Ogbonna-Joseph/HERTZ200/Hertz200/Documents/NOTES.txt

MCU - BULK CONVERTER IN DC JACK TO MCU FOR POWER SIGNAL FUNCTION\

NB-IOT CHIP - TRANSISTOR FOR POWER ON/OFF

ESD ALL

SWITCH FOR BATTERY

CAPACITORS FOR ANTENNAS
