Ogbonna-Joseph/HERTZ200/Hertz200/Documents/HERTZ200_CHIP_CONNECTIONS.png

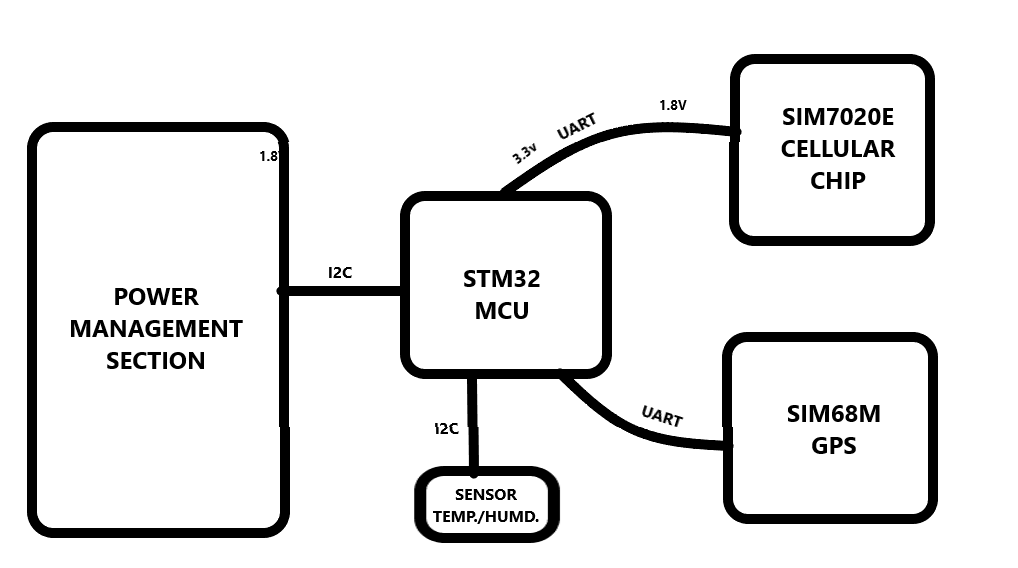
Hertz200/Documents/HERTZ200_CHIP_CONNECTIONS.png
