Ogbonna-Joseph/HERTZ200/Hertz200/Documents/HERTZ200_POWER_BUDGET.png

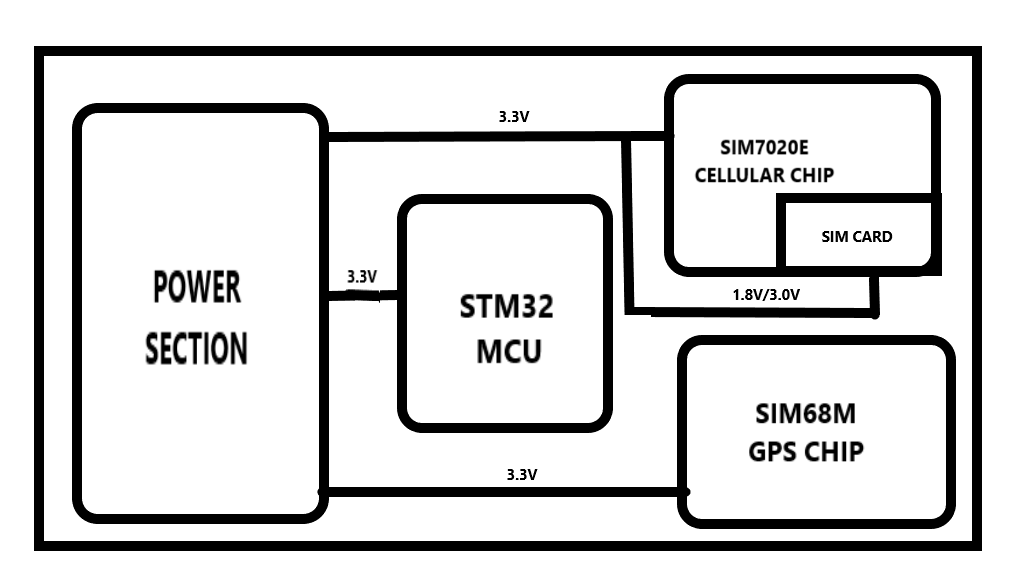
Hertz200/Documents/HERTZ200_POWER_BUDGET.png
