Ogbonna-Joseph/HERTZ200/Hertz200/Documents/Images/Layout001.png

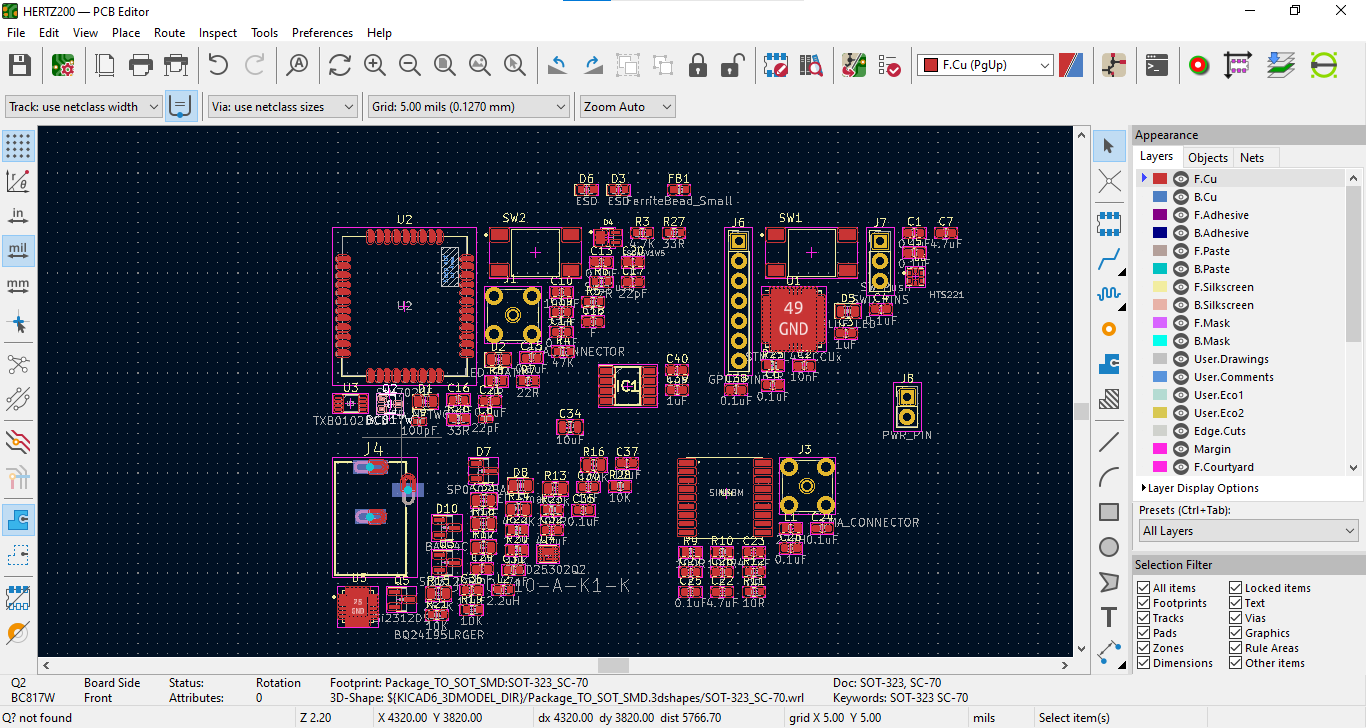
Hertz200/Documents/Images/Layout001.png
