Ogbonna-Joseph/HERTZ200/Hertz200/Documents/Images/layout002.png

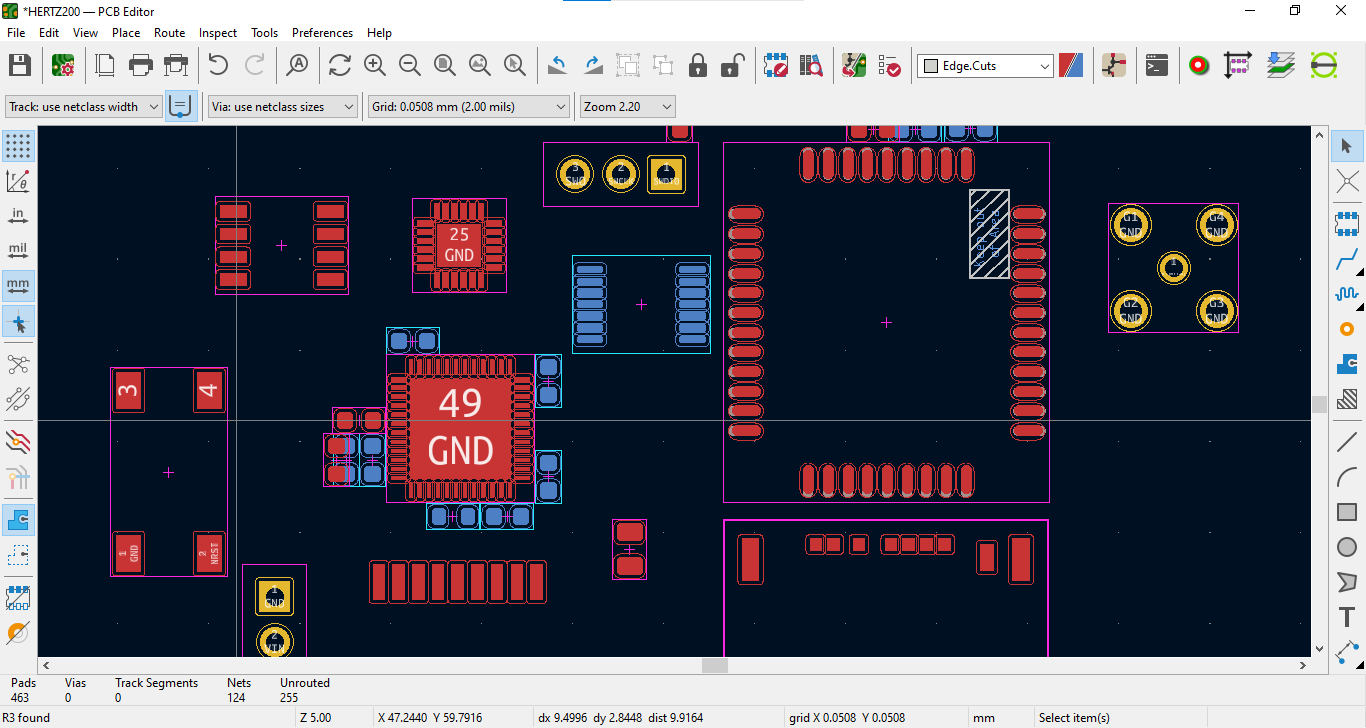
Hertz200/Documents/Images/layout002.png
