Ogbonna-Joseph/HERTZ200/Hertz200/Documents/Images/layout003.png

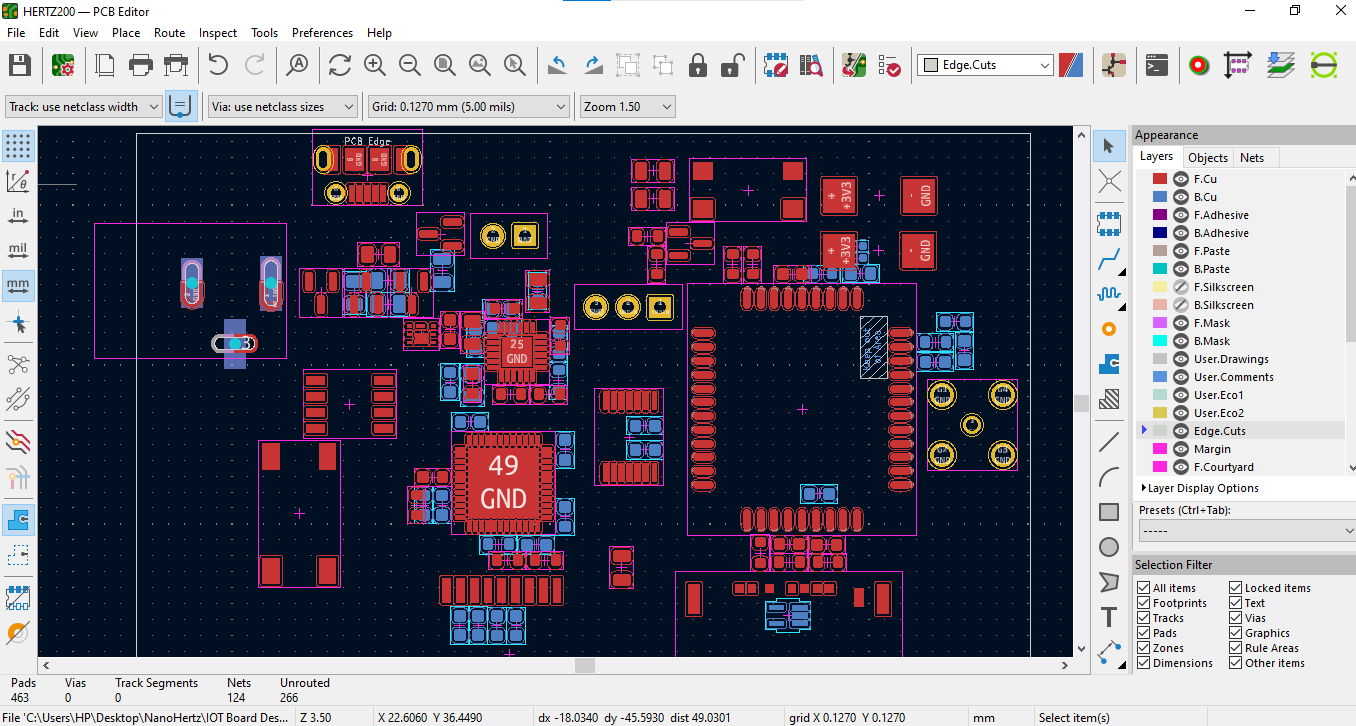
Hertz200/Documents/Images/layout003.png
