Ogbonna-Joseph/HERTZ200/Hertz200/Documents/Images/MCU_PINS.png

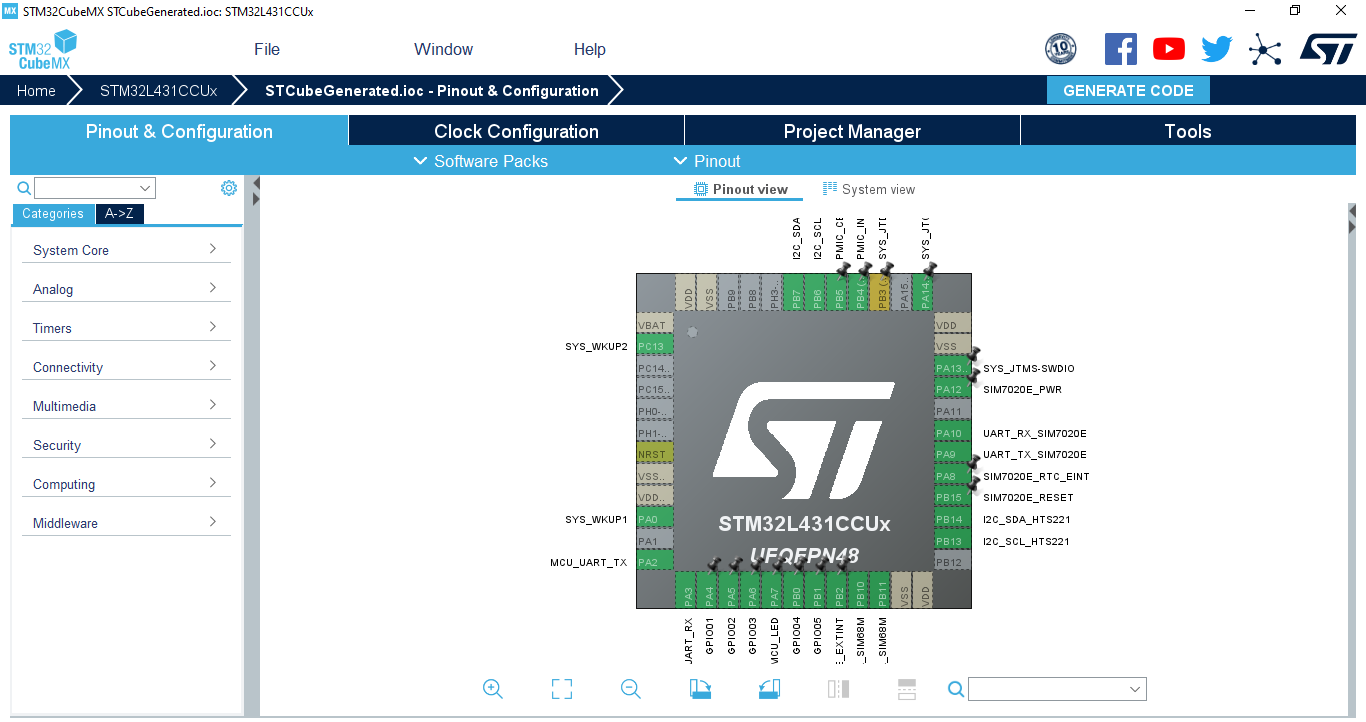
Hertz200/Documents/Images/MCU_PINS.png
