Ogbonna-Joseph/HERTZ200/Hertz200/Documents/Images/SIM7020E SCHEMATICS.png

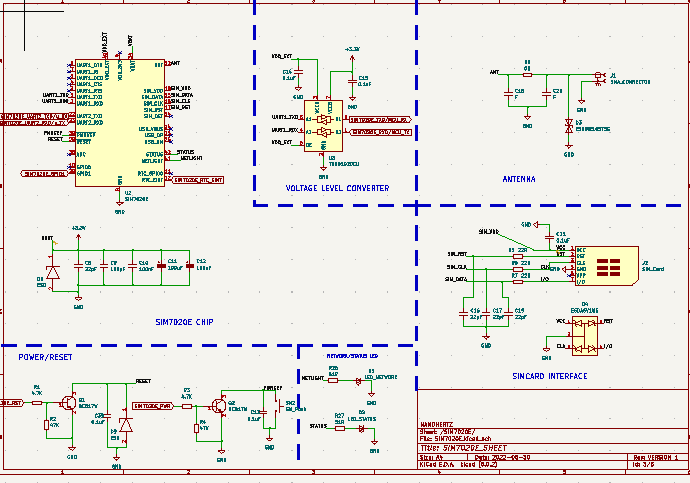
Hertz200/Documents/Images/SIM7020E SCHEMATICS.png
