Ogbonna-Joseph/HERTZ200/Hertz200/Documents/BOM.xlsx

 | QUANTITY | REF. DESIGNATOR | MANUFACTURER | MANF. PART NO. | DESCRIPTION | PACKAGE | TYPE | VALUE | REFERENCE
1 | 1 |  | STMICROELECTRONICS | STM32L431CCU6 | MICROCONTROLLER | UFQFPN-48 | SMT
2 | 1 |  | SIMCOM | SIM7020E | NB-IOT MODULE | LCC, 42PIN | SMT
3 | 1 |  | SIMCOM | SIM68M | GNSS MODULE |  | SMT
4 | 1 |  | TEXAS INSTRUMENT | BQ24195LRGER | BATTERY MANAGEMENT | VQFN-24 | SMT
5 | 1 |  | TEXAS INSTRUMENT | TXB0104PWR | VOLTAGE LEVEL TRANSLATOR | 14-TSSOP | SMT
7 | 2 |  | TEXAS INSTRUMENT | TL3305AF160QG | TACTILE SWITCH |  | SMT
8 | 1 |  | ROHM Semiconductor | BD33HC5MEFJ-ME2 | LDO VOLTAGE REGULATOR | HTSOP-J-8 | SMT
9 | 1 |  | Toshiba | TAR5S33UTE85LF | LDO Voltage Regulators | SOT-353-5 | SMT
10 | 1 |  | Molex | 503960-0696 | SIM CARD CONNECTOR |  | SMT
11 | 2 |  | LPRS | SMA CONNECTOR | COAXIAL CONNECTOR SMA STRAIGHT |  | PTH
12 | 1 |  | Gravitech (https://www.mouser.com/manufacturer/gravitech/) | CON-SOCJ-2155 | DC JACK |  | PTH
13 | 1 |  | TEXAS INSTRUMENT | CSD25302Q2 | POWER MOSFET | WSON-FET-6 | SMT
14 | 2 |  | VISHAY | Si2312DS | TRANSISTOR |  | SMT
15 |  |  |  |  | TRANSISTOR
16 | 1 |  | Epcos/TDK | B82496C3270J | INDUCTOR | 0603 | SMT | 27nH
17 | 1 |  | Murata Electronics | LQM18PN2R2MFHD | INDUCTOR | 0603 | SMT | 2.2uH
18 | 4 |  | Wurth Elektronik | 150080RS75000 | LED | 0805 | SMT
19 | 3 |  | ROHM SEMICONDUCTORS | SDR03EZPF33R0 | RESISTOR | 0603 | SMT | 33R
20 | 1 |  | ROHM SEMICONDUCTORS | SDR03EZPF2201 | RESISTOR | 0603 | SMT | 2.2K
21 | 6 |  | Bourns | CMP0603AFX-1002ELF | RESISTOR | 0603 | SMT | 10K
22 | 2 |  | ROHM SEMICONDUCTORS | SDR10EZPJ103 | RESISTOR | 0805 | SMT | 10K
23 | 1 |  | PANASONIC | ERA-6APB104V | RESISTOR | 0805 | SMT | 100K
24 | 1 |  | PANASONIC | ERA-6AEB2613V | RESISTOR | 0805 | SMT | 262K | 261K ACTUAL VALUE
25 | 1 |  | PANASONIC | ERA-6AEB4992V | RESISTOR | 0805 | SMT | 49.9K
26 | 1 |  | PANASONIC | ERA-6AEB1213V | RESISTOR | 0805 | SMT | 121K
27 | 1 |  | Bourns | CMP0603-FX-10R0ELF | RESISTOR | 0603 | SMT | 10R
28 | 3 |  | Bourns | CMP0603AFX-1000ELF | RESISTOR | 0603 | SMT | 100R
29 | 3 |  | ROHM SEMICONDUCTORS | SFR03EZPF22R0 | RESISTOR | 0603 | SMT | 22R
30 | 1 |  | PANASONIC | ERJ-3EKF4702V | RESISTOR | 0603 | SMT | 47K
31 | 1 |  | ROHM SEMICONDUCTORS | SDR03EZPJ472 | RESISTOR | 0603 | SMT | 4.7K
32 | 1 |  | Bourns | CR0805-JW-131ELF | RESISTOR | 0805 | SMT | 130R
33 | 3 |  | Bourns | CR0603AJ/-000EAS | RESISTOR | 0603 | SMT | 0R
 | 1 |  |  |  | RESISTOR | 0603 | SMT | 33K
35 | 1 |  | Murata Electronics | GRM219R61H105KA73D | CAPACITOR | 0805 | SMT | 1uF
36 | 2 |  | Murata Electronics | GRM21BR61H106KE43K | CAPACITOR | 0805 | SMT | 10uF
37 | 3 |  | Murata Electronics | GRM188R61E106KA73J | CAPACITOR | 0603 | SMT | 10uF
38 | 1 |  | TDK | CGA3E2X7R1H473K080AA | CAPACITOR | 0603 | SMT | 47nF
39 | 1 |  | Murata Electronics | GCM1885C1H102FA16D | CAPACITOR | 0603 | SMT | 1nF
40 | 3 |  | KEMET | C0603C220J5GAC7867 | CAPACITOR | 0603 | SMT | 22pF
41 | 1 |  | KEMET | T491X107K025AT | CAPACITOR POLARIZED |  | SMT | 100uF
42 | 1 |  | KEMET | C0402C101J5GACAUTO | CAPACITOR | 0402 | SMT | 100pF
43 | 1 |  | KEMET | C0402C220J5GACAUTO | CAPACITOR | 0402 | SMT | 22pF
44 | 4 |  | TDK | C1608X6S1A475K080AC | CAPACITOR | 0603 | SMT | 4.7uF
45 | 4 |  | TDK | C1608X5R1H105K080AB | CAPACITOR | 0603 | SMT | 1uF
46 | 2 |  | KEMET | C0603C103K5RAC7013 | CAPACITOR | 0603 | SMT | 10nf
47 | 15 |  | KEMET | C0603C104K5RAC3121 | CAPACITOR | 0603 | SMT | 0.1uF
48 |  |  |  |  | CAPACITOR FOR ANTENNA
49 | 1 |  |  | JST XH 2.54 2-Pin | 2 Pin battery connector |  | PTH |  | https://www.pcboard.ca/jst-xh-2-pin
50 | 1 |  | TE Connectivity (https://www.mouser.com/manufacturer/te-connectivity/) | 87220-3 | CONNECTOR 3 PIN |  | PTH
51 | 1 |  | Molex | 22-28-5070 | CONNECTOR 7 PIN |  | PTH
52 | 1 |  | Murata Electronics | LXES15AAA1-153 | ESD for RF chip (SIM7020E) | 0402 | SMT
 | 2 |  | ONSEMI | ESD9L5.0ST5G | ESD for USB | SOD-923-2 | SMT
 | 1 |  | Molex | 105164-0001 | USB Connector Type B |  | SMT
 | 1 |  | TEXAS INSTRUMENT | TMP451HQDQWTQ1 | TEMPERATURE SENSOR |  | smt
 | 1 |  |  |  | RESISTOR | 0603 | SMT | 200R
 | 1 |  | GCT | USB4125-GF-A-0190 | USB TYPE C |  | SMT
 | 2 |  |  |  | RESISTOR | 0603 | SMT | 5.1K
 | 1 |  | Rectron | BC847-T | TRANSISTOR | SOT23-3 | SMT
