Ogbonna-Joseph/HERTZ200/Hertz200/PCB_DESIGN/HERTZ200/Hertz200_BOM.xlsx

QUANTITY | REF. DESIGNATOR | VALUE | MANF. PART NO. | MANUFACTURER | DESCRIPTION | PACKAGE | TYPE | REFERENCE | PRICE
16 | C1, C4, C5, C6, C10, C11, C13, C14, C15, C20, C21, C24, C26, C27, C28, C48 | 0.1uF | 06033C104JAZ2A | Kyocera AVX | CAPACITOR | 0603 | SMT
2 | C2, C31 | 10nF | C0603C103J5RACTU | KEMET | CAPACITOR | 0603 | SMT
5 | C3, C18, C30, C33, C47 | 1uF | C1608X5R1H105K080AB | TDK | CAPACITOR | 0603 | SMT
2 | C7, C22 | 4.7uF | GRT188R61E475KE13D | MURATA ELECTRONICS | CAPACITOR | 0603 | SMT
1 | C8 | 22pF | C0402C220J5GACAUTO | KEMET | CAPACITOR | 0402 | SMT
1 | C9 | 100pF | C0402C101J5GACAUTO | KEMET | CAPACITOR | 0402 | SMT
5 | C12, C38, C44, C45, C46 | 22uF | CL31A226KOHNNWE | Samsung Electro-Mechanics (https://eu.mouser.com/manufacturer/samsung-electro-mechanics/) | CAPACITOR | 1206 | SMT
3 | C16, C17, C19 | 22pF | C0603C220J5GAC7867 | KEMET | CAPACITOR | 0603 | SMT
1 | C29 | 1uF | GRM219R61H105KA73D | MURATA ELECTRONICS | CAPACITOR | 0805 | SMT
1 | C32 | 10uF | GRM188R61E106KA73J | MURATA ELECTRONICS | CAPACITOR | 0603 | SMT
1 | C34 | 0.1uF | VJ0805Y104JXXPW1BC | Vishay / Vitramon (https://eu.mouser.com/manufacturer/vitramon/) | CAPACITOR | 0805 | SMT
3 | R1, R8, R12 | 0R | CR0603AJ/-000EAS | BOURNS | RESISTOR | 0603 | SMT
1 | R2 | 130R | CR0805-JW-131ELF | BOURNS | RESISTOR | 0805 | SMT
1 | R3 | 4.7K | SDR03EZPJ472 | ROHM SEMI CONDUCTORS | RESISTOR | 0603 | SMT
1 | R4 | 47K | ERJ-3EKF4702V | PANASONIC | RESISTOR | 0603 | SMT
3 | R5, R6, R7 | 22R | SFR03EZPF22R0 | ROHM SEMI CONDUCTORS | RESISTOR | 0603 | SMT
2 | R9, R10 | 100R | CMP0603AFX-1000ELF | BOURNS | RESISTOR | 0603 | SMT
1 | R11 | 10R | CMP0603-FX-10R0ELF | BOURNS | RESISTOR | 0603 | SMT
1 | R13 | 2.2K | SDR03EZPF2201 | ROHM SEMI CONDUCTORS | RESISTOR | 0603 | SMT
2 | R14, R15 | 5.1M | ESR10EZPJ515 | ROHM SEMI CONDUCTORS | RESISTOR | 0805 | SMT
1 | R16 | 330R | CMP0805AFX-3300ELF | BOURNS | RESISTOR | 0805 | SMT
1 | R24 | 33K | SDR03EZPJ333 | ROHM SEMI CONDUCTORS | RESISTOR | 0603 | SMT
3 | R25, R26, R27 | 33R | SDR03EZPF33R0 | ROHM SEMI CONDUCTORS | RESISTOR | 0603 | SMT
7 | R29, R30, R37, R39, R42, R50, R51 | 10K | CMP0603AFX-1002ELF | BOURNS | RESISTOR | 0603 | SMT
2 | R33, R34 | 5.1K | SDR03EZPF5101 | ROHM SEMI CONDUCTORS | RESISTOR | 0603 | SMT
1 | R35 | 23.7K | ERJ-UP3F2372V | PANASONIC | RESISTOR | 0603 | SMT
1 | R36 | 15K | SDR03EZPJ153 | ROHM SEMI CONDUCTORS | RESISTOR | 0603 | SMT
1 | R38 | 47.5K | ERJ-UP3F4752V | PANASONIC | RESISTOR | 0603 | SMT
1 | R40 | 13.3K | ERJ-UP3F1332V | PANASONIC | RESISTOR | 0603 | SMT
3 | R43, R44, R45 | 2K | SFR03EZPF2001 | ROHM SEMI CONDUCTORS | RESISTOR | 0603 | SMT
1 | R46 | 20m | RL3264-6-R020-FN | CYNTEC | RESISTOR | 2512 | SMT
1 | R47 | 1K | RC0603FR-071KL | YAGEO | RESISTOR | 0603 | SMT
1 | R48 | 37.4K | RC0603FR-0737K4L | YAGEO | RESISTOR | 0603 | SMT
1 | R49 | 31.6K | RC0603FR-0731K6L | YAGEO | RESISTOR | 0603 | SMT
1 | D1 | LED_NETWORK | 150080RS75000 | Wurth Elektronik | LED | 0805 | SMT
1 | D2 | LED_STATUS | 150080RS75000 | Wurth Elektronik | LED | 0805 | SMT
1 | D3 | LXES15AAA1-153 | LXES15AAA1-153 | MURATA ELECTRONICS |  | 0402 | SMT
1 | D4 | ESDA6V1W5 | ESDA6V1W5 | STMicroelectronics | ESD |  | SMT
1 | D5 | BLUE_LED | 150060RS75000 | Wurth Elektronik | LED | 0805 | SMT
1 | D6 | ESD |  |  |  | 0603 | SMT
2 | D7, D9 | ESD9L5.0ST5G | ESD9L5.0ST5G | ONSEMI | ESD
1 | D10 | BLUE_LED | LB Q39E-L2OO-35-1 | ams OSRAM | LED | 0603 | SMT
2 | D11, D12 | BLUE_LED | LB Q39E-L2OO-35-1 | ams OSRAM | LED | 0603 | SMT
1 | IC1 | BD33HC5MEFJ-ME2 | BD33HC5MEFJ-ME2 | ROHM Semiconductor | LDO REGULATOR | HTSOP-J-8 | SMT
1 | IC2 | TMP451HQDQWTQ1 | TMP451HQDQWTQ1 | TEXAS INSTRUMENT | TEMPERATURE SENSOR | WSON-8 | SMT
1 | IC3 | BQ29701DSET | BQ29701DSET | TEXAS INSTRUMENT | BATTERY MANAGEMENT | WSON-6 | SMT
2 | J1, J3 | SMA_CONNECTOR | SMA CONNECTOR | LPRS | CONNECTOR STRAIGHT |  | PTH
1 | J2 | 503960-0696 | 503960-0696 | MOLEX | SIM CARD CONNECTOR |  | SMT
1 | J4 | GPIO_PINS |  |  |  |  | PTH
1 | J5 | 105164-0001 | 105164-0001 | MOLEX | USB TYPE B CONNECTOR |  | SMT
1 | J7 | SWD_PINS | 87220-3 | TE CONNECTIVITY | FEMALE PIN CONNECTOR |  | PTH
1 | J8 | USB4125-GF-A-0190_REVA2 | USB4125-GF-A-0190 | GCT | USB TYPE C CONNECTOR |  | SMT
1 | L1 | 27nH | B82496C3270J | Epcos/TDK | INDUCTOR | 0603 | SMT
1 | L3 | 1.5uH | 744311150 | Wurth Elektronik | INDUCTOR |  | SMT
1 | PS1 | TAR5SB33_TE85L,F_ | TAR5S33UTE85LF | TOSHIBA | LDO REGULATOR | SOT-353-5 | SMT
2 | Q1, Q3 | CSD16301Q2 | CSD16301Q2 | TEXAS INSTRUMENT | MOSFET | WSON-6 | SMT
1 | Q2 | BC847-T | BC847-T | RECTRON | TRASISTOR | SOT23-3 | SMT
2 | S1, S2 | TL3305AF160QG | TL3305AF160QG | TEXAS INSTRUMENT | TACTILE SWITCH |  | SMT
1 | U1 | STM32L431CCUx | STM32L431CCU6 | STMicroelectronics | MICROCONTROLLER | UFQFPN-48 | SMT
1 | U2 | SIM7020E | SIM7020E | SIMCOM | NB-IOT MODULE | LCC, 42PIN | SMT
1 | U3 | TXB0104PW | TXB0104PWR | TEXAS INSTRUMENT | VOLTAGE LEVEL TRANSLATOR | 14-TSSOP | SMT
1 | U4 | SIM68M | SIM68M | SIMCOM | GPS/GNSS |  | SMT
1 | U6 | MP2636GR-P | MP2636GR-P | Monolithic Power Systems (MPS) | BATTERY MANAGEMENT |  | SMT
2 | U7, U8 | 100uF | T491X107K025AT | KEMET | CAPACITOR POLARIZED |  | SMT
1 | BT1 |  | JST XH 2.54mm 2-Pin |  | FEMALE BATTERY CONNECTOR |  | PTH
