Ogbonna-Joseph/HERTZ200/Hertz200/Documents/Hert200_Parameters01.xlsx

Sheet: Sheet1
MCU/CHIPSET | TYPE | OPERATING VOLTAGE (V) | INTERFACE | CURRENT (mA) | POWER (W) | SLEEP MODE(uA)
STM32L431CC | PROCESSOR | 3.3 | USART | 140 | 0.462 | 0.300
 |  |  | SPI
 |  |  | I2C
SIM7020E | NB-IOT CELLULAR | 3.3 | UART | 800 | 2.640 | 3.400
SIM68M | GNSS/GPS | 3.3 | UART | 30 | 0.100 | 14.000
HT221 TEMP/HUMIDITY | SENSOR |  | SPI
 |  |  | I2C
BQ24195RGER | BATTERY IC | 6-24 | I2C | 3A MAX
MCU TOTAL CRT/PWR |  |  |  | 970 | 3.202 | 18.000
TXB0102DCUT | Volatge Level Shifter
BATTERY | LITHIUM ION | 3.8 X 2 |  | (5-10)AH
CAPACITORS | SMD | 0.1uF/50V | 603 | C0603C104K5RAC3121
 |  | 1uF/50V | 0603 | CGA3E3X5R1H105K080AB

Sheet: Sheet2
CAPACITORS
PART NO. | VALUE | VOLTAGE | DESCRIPTION | size | PRICE $
C0603C104K5RAC3121 | 0.1uF | 50V | for power and other function | 0603 | 0.13
C0603C103K5RAC7013 | 10nF | 50V | STM32 L4 VDDA | 0603 | 0.13
C1608X5R1H105K080AB | 1uF | 50V | STM32 L4 VDDA | 0603 | 0.22
C0402C220J5GACAUTO | 22pF | 50V | SIM7020E VDD | 0402 | 0.11
C0402C101J5GACAUTO | 100pF | 50v | SIM7020E VDD | 0402 | 0.12
T491X107K025AT | 100uF | 25v | SIM7020E VDD |  | 3.34
C0603C220J5GAC7867 | 22pF | 50V | SIM7020E SIM SLOT | 0603 | 0.15
C1608X6S1A475K080AC | 4.7uF | 50V | SIM68 POWER | 0603 | 0.25
GCM1885C1H102FA16D | 1nF | 50V | PMIC | 0603 | 0.37
CGA3E2X7R1H473K080AA | 47nF | 50V | PMIC | 0603 | 0.16
GRM188R61E106KA73J | 10uF | 25v |  | 0603 | 0.30
LED
150080RS75000 |  | 2V | led | 805 | 0.19
RESISTOR
R13-R18 |  | 1W |  | 0805
Resistors |  | 300mW | ROHM SEMICONDUCTORS | 0603 | 0.17
BAT54C |  |  |  | SOT 23 | 0.43
CDBU0130-HF |  |  | Schokley diode |  | 0.5
DCJ250-10-A-K1-K |  |  | DC Barrel Jack |  | 0.74
BD33HC5MEFJ-ME2 |  | 3.3 | LDO 3.3V |  | 1.43
TL3305AF160QG |  |  | SWITCH TACTILE |  | 0.21
LQG18HN27NJ00D |  |  | GPS INDUCTOR | 603 | 0.20
LQM18PN2R2MFHD |  |  | PMIC INDUCTOR | 603 | 0.31
105017-0001 |  |  | Female USB connector |  | 0.95
503960-0696 |  |  | SIM CONNECTOR from Molex |  | 2.82
TXB0104QPWRQ1 |  |  | 4bit BiDir Logic level converter |  | 1.41
