Ogbonna-Joseph/HERTZ200/Hertz200/PCB_DESIGN/HERTZ200/HERTZ200.kicad_pcb

## KiCad design Hertz200/PCB_DESIGN/HERTZ200/HERTZ200.kicad_pcb (2022-10-03)

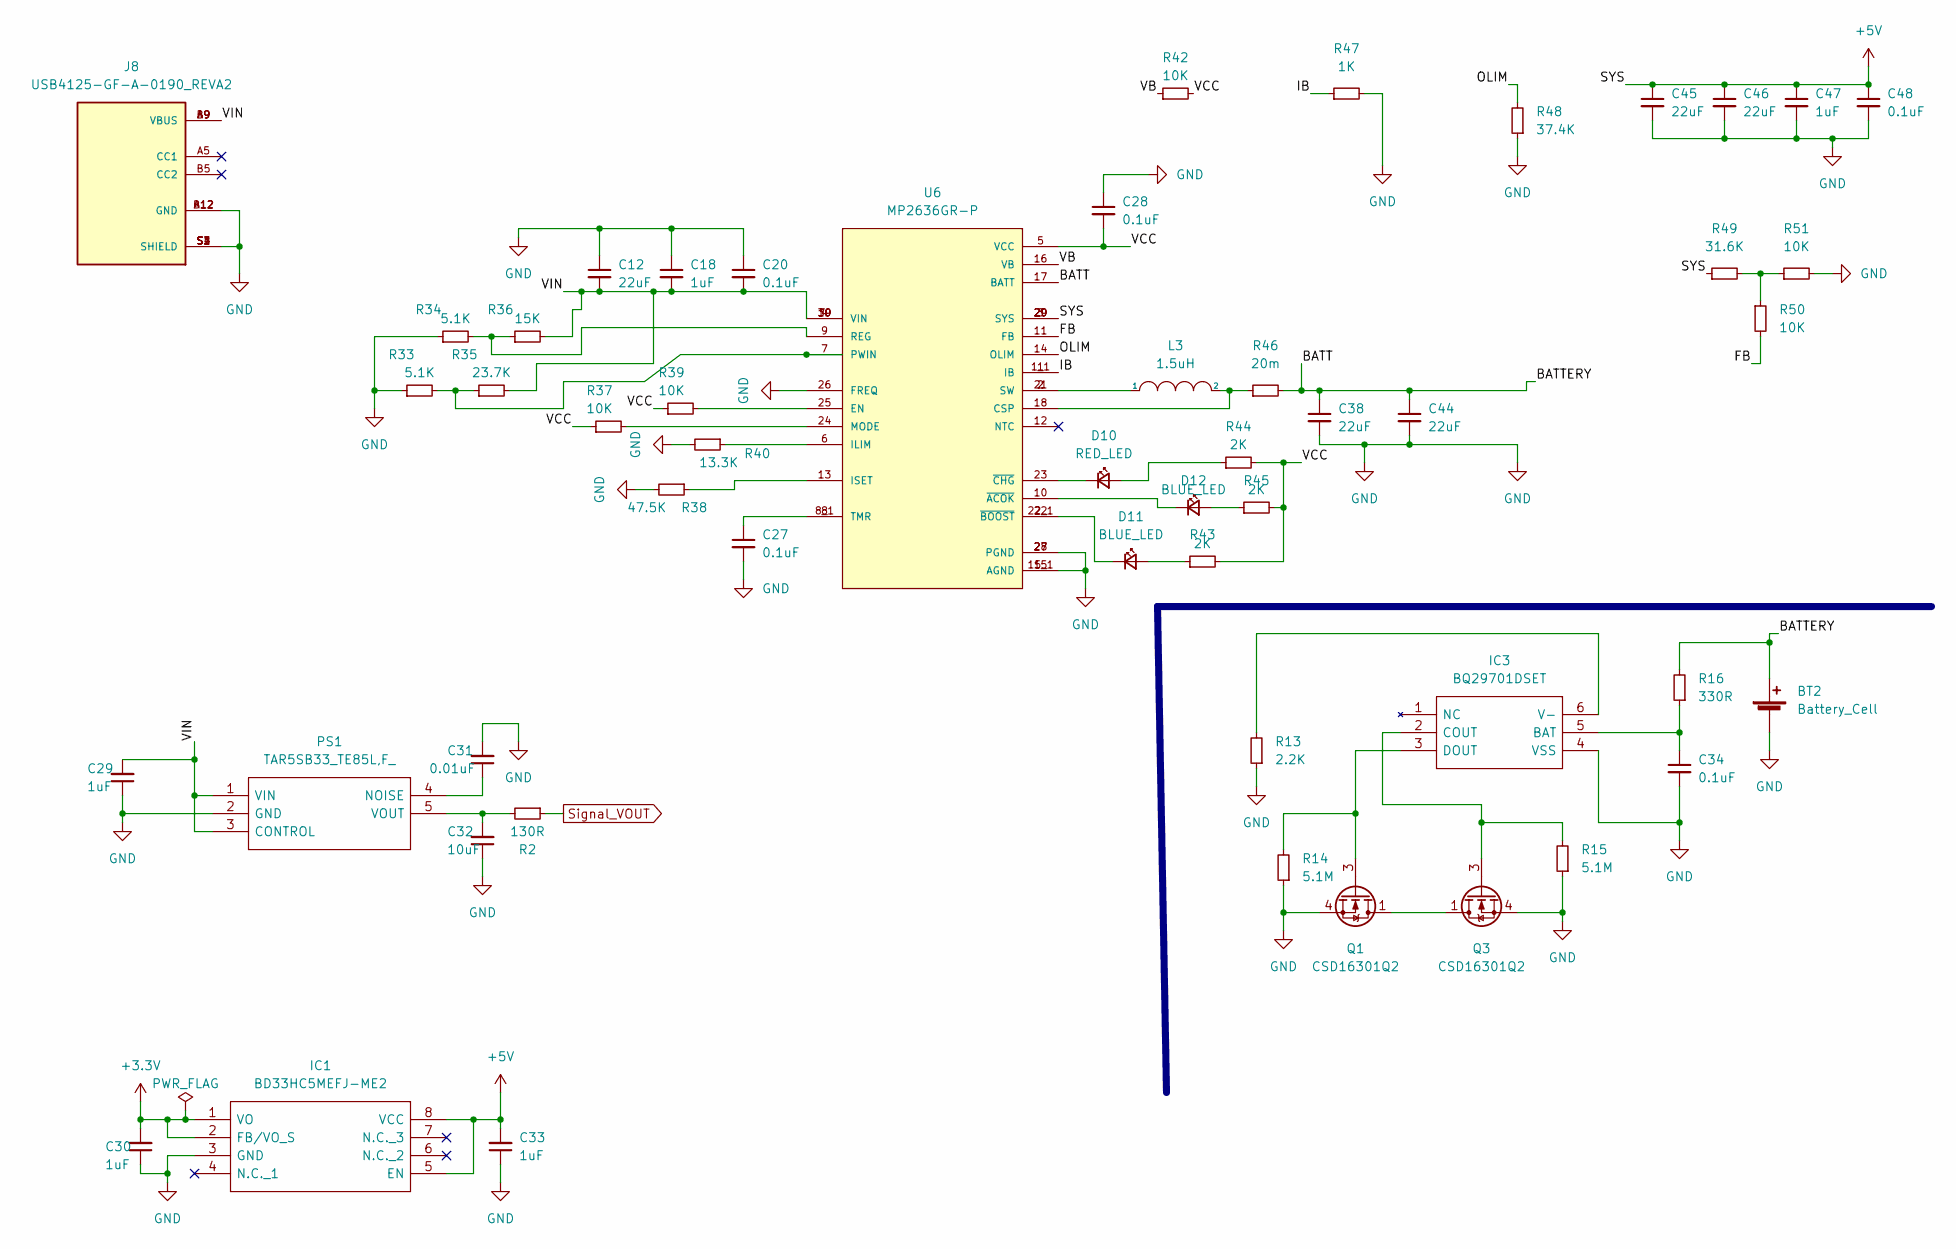
[picture p8: schematic MP2636.kicad_sch]

Parts:
BT2: Battery_Cell; PinHeader_1x02_P2.54mm_Vertical
C12, C38, C44, C45, C46: 22uF; C_1206_3216Metric
C18, C30, C33, C47: 1uF; C_0603_1608Metric
C20, C27, C28, C48: 0.1uF; C_0603_1608Metric
C29: 1uF; C_0805_2012Metric
C31: 0.01uF; C_0603_1608Metric
C32: 10uF; C_0603_1608Metric
C34: 0.1uF; R_0805_2012Metric
D10: RED_LED; LED_0603_1608Metric
D11, D12: BLUE_LED; LED_0603_1608Metric
IC1: BD33HC5MEFJ-ME2; SOIC127P600X100-8N; Mouser Part Number 755-BD33HC5MEFJ-ME2
IC3: BQ29701DSET; Mouser Part Number 595-BQ29701DSET
J8: USB4125-GF-A-0190_REVA2; GCT_USB4125-GF-A-0190_REVA2; PARTREV Rev A2
L3: 1.5uH; WE-HCI_7030_7040_705023
PS1: TAR5SB33_TE85L,F_; SOT95P275X140-5N; Manufacturer_Part_Number TAR5SB33(TE85L,F); Mouser Part Number 757-TAR5SB33TE85LF
Q1, Q3: CSD16301Q2; Texas_DQK
R2: 130R; R_0805_2012Metric
R13: 2.2K; R_0603_1608Metric
R14, R15: 5.1M; R_0805_2012Metric
R16: 330R; R_0805_2012Metric
R33, R34: 5.1K; R_0603_1608Metric
R35: 23.7K; R_0603_1608Metric
R36: 15K; R_0603_1608Metric
R37, R39, R42, R50, R51: 10K; R_0603_1608Metric
R38: 47.5K; R_0603_1608Metric
R40: 13.3K; R_0603_1608Metric
R43, R44, R45: 2K; R_0603_1608Metric
R46: 20m; R_2512_6332Metric
R47: 1K; R_0603_1608Metric
R48: 37.4K; R_0603_1608Metric
R49: 31.6K; R_0603_1608Metric
U6: MP2636GR-P; IC_MP2636GR-P; PARTREV 1.02

Connections:
+3V3: C30.2, IC1.1 (VO), IC1.2 (FB/VO_S); also elsewhere on the board
+5V: C33.2, C45.1, C46.1, C47.1, C48.1, IC1.5 (EN), IC1.8 (VCC), R49.1, U6.3 (SYS), U6.20 (SYS), U6.29 (SYS)
/MP2636/BATT: BT2.1 (+), C38.1, C44.1, R16.2, R46.2, U6.17 (BATT)
/MP2636/FB: R50.2, U6.11 (FB)
/MP2636/IB: R47.1, U6.1 (IB), U6.1_1 (IB)
/MP2636/OLIM: R48.2, U6.14 (OLIM)
/MP2636/VB: R42.1, U6.16 (VB)
/MP2636/VCC: C28.2, R37.1, R39.1, R42.2, R43.2, R44.2, R45.2, U6.5 (VCC)
/MP2636/VIN: C12.2, C18.2, C20.2, C29.2, J8.A9 (VBUS), J8.B9 (VBUS), PS1.1 (VIN), PS1.3 (CONTROL), R35.2, R36.2, U6.4 (VIN), U6.19 (VIN), U6.30 (VIN)
GND: BT2.2 (-), C12.1, C18.1, C20.1, C27.2, C28.1, C29.1, C30.1, C31.2, C32.1, C33.1, C34.2, C38.2, C44.2, C45.2, C46.2, C47.2, C48.2, IC1.3 (GND), IC3.4 (VSS), J8.A12 (GND), J8.B12 (GND), J8.S1 (SHIELD), J8.S2 (SHIELD), J8.S3 (SHIELD), J8.S4 (SHIELD), PS1.2 (GND), Q1.4 (S), Q1.7 (S), Q3.4 (S), Q3.7 (S), R13.1, R14.1, R15.1, R33.1, R34.1, R38.2, R40.2, R47.2, R48.1, R51.2, U6.15 (AGND), U6.15_1 (AGND), U6.26 (FREQ), U6.27 (PGND), U6.28 (PGND); also elsewhere on the board
unnamed: C27.1, U6.8 (TMR), U6.8_1 (TMR)
unnamed: C31.1, PS1.4 (NOISE)
unnamed: C32.2, PS1.5 (VOUT), R2.2
unnamed: C34.1, IC3.5 (BAT), R16.1
unnamed: D10.1 (K), U6.23 (~CHG)
unnamed: D10.2 (A), R44.1
unnamed: D11.1 (K), U6.22 (~BOOST), U6.22_1 (~BOOST)
unnamed: D11.2 (A), R43.1
unnamed 53: D12.1 (K), U6.10 (~ACOK); also elsewhere on the board
unnamed 54: D12.2 (A), R45.1; also elsewhere on the board
unnamed: IC3.2 (COUT), Q3.3 (G), R15.2
unnamed: IC3.3 (DOUT), Q1.3 (G), R14.2
unnamed: IC3.6 (V-), R13.2
unnamed: L3.1, U6.2 (SW), U6.21 (SW)
unnamed: L3.2, R46.1, U6.18 (CSP)
unnamed: Q1.1 (D), Q1.2 (D), Q1.5 (D), Q1.6 (D), Q1.8 (D), Q3.1 (D), Q3.2 (D), Q3.5 (D), Q3.6 (D), Q3.8 (D)
unnamed: R33.2, R35.1, U6.7 (PWIN)
unnamed: R34.2, R36.1, U6.9 (REG)
unnamed: R37.2, U6.24 (MODE)
unnamed: R38.1, U6.13 (ISET)
unnamed: R39.2, U6.25 (EN)
unnamed: R40.1, U6.6 (ILIM)
unnamed: R49.2, R50.1, R51.1
Signal_VOUT: R2.1; also elsewhere on the board

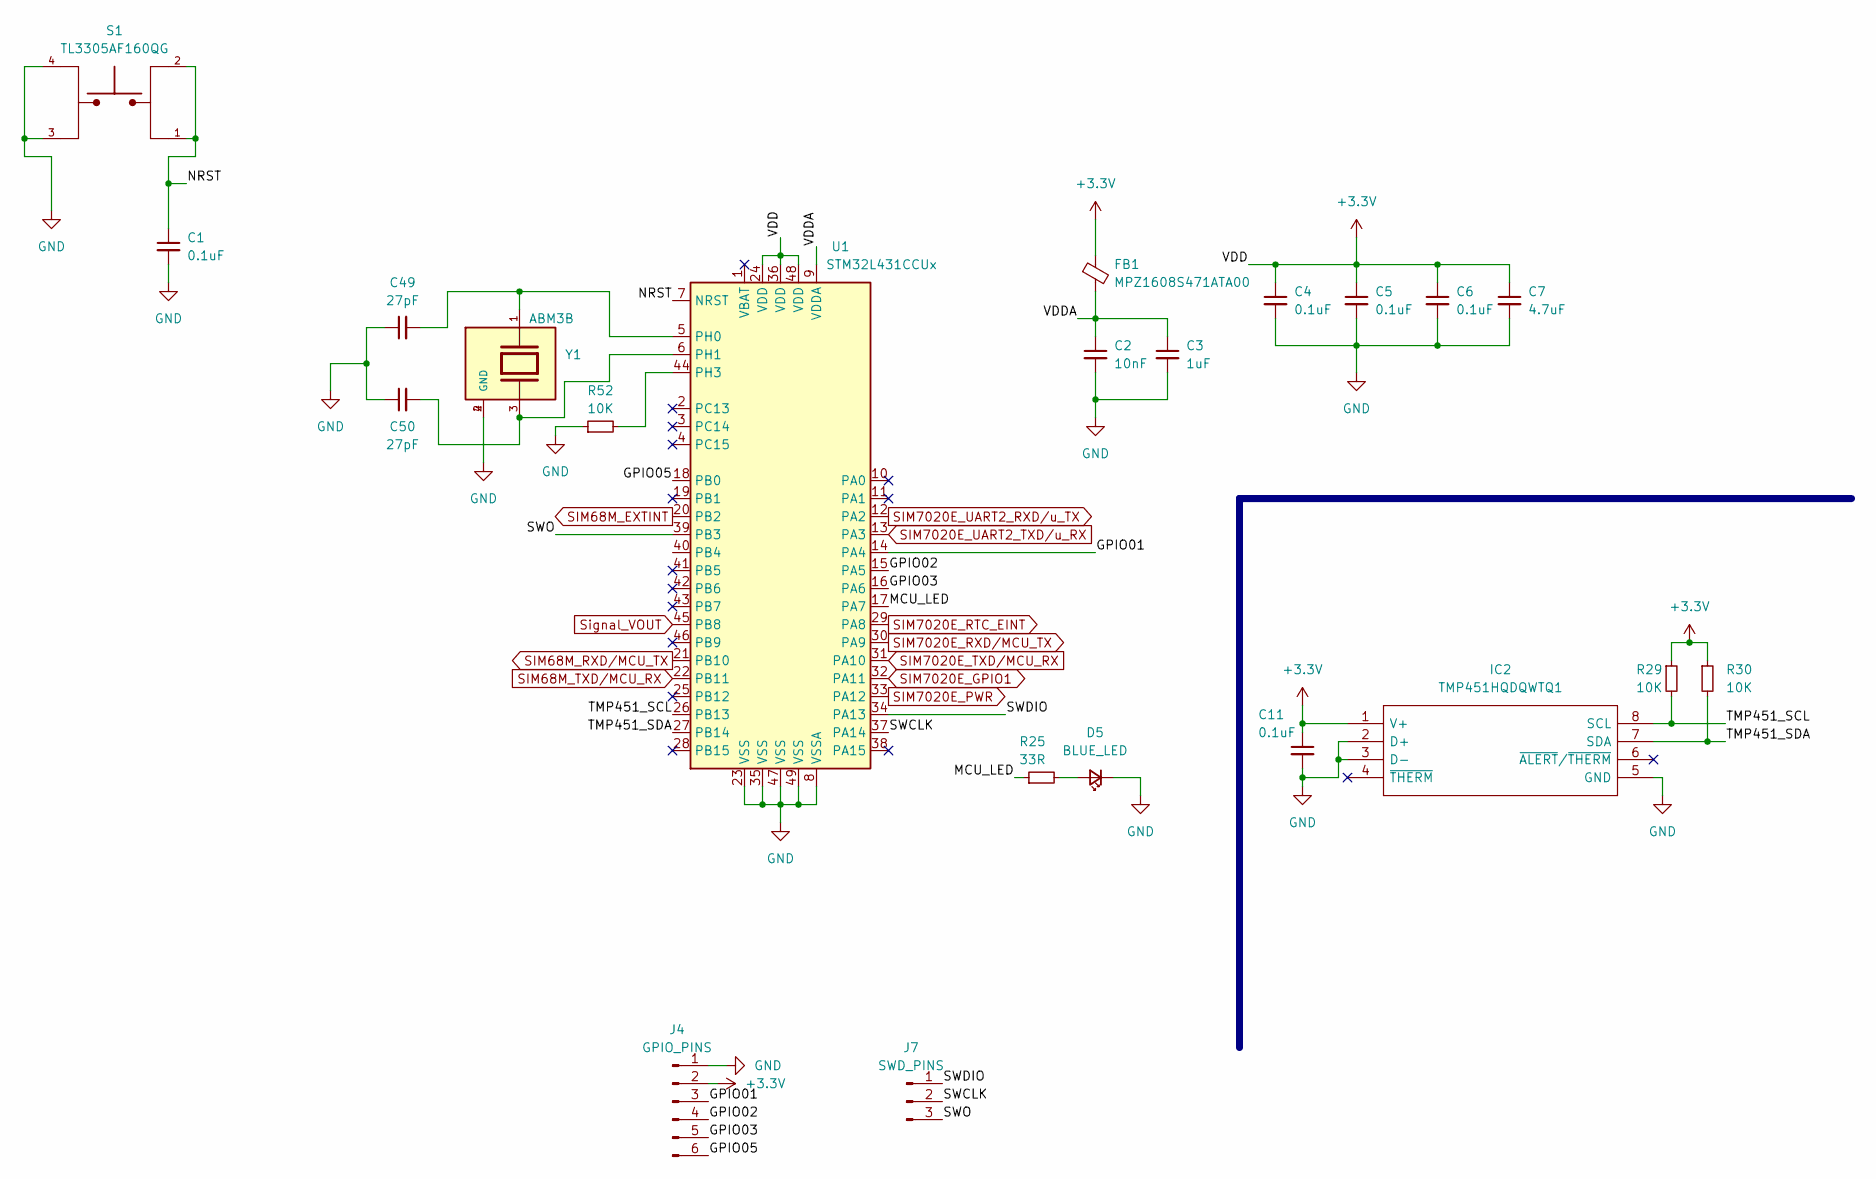
[picture p9: schematic STM32L432.kicad_sch, STM32L431CC]

Parts:
C1, C4, C5, C6, C11: 0.1uF; C_0603_1608Metric
C2: 10nF; C_0603_1608Metric
C3: 1uF; C_0603_1608Metric
C7: 4.7uF; C_0603_1608Metric
C49, C50: 27pF; C_0603_1608Metric
D5: BLUE_LED; LED_0805_2012Metric
FB1: MPZ1608S471ATA00; L_0603_1608Metric
IC2: TMP451HQDQWTQ1; SON50P250X200X80-8N; Mouser Part Number 595-TMP451HQDQWTQ1
J4: GPIO_PINS; PinHeader_1x06_P2.54mm_Vertical
J7: SWD_PINS; PinHeader_1x03_P2.54mm_Vertical
R25: 33R; R_0603_1608Metric
R29, R30, R52: 10K; R_0603_1608Metric
S1: TL3305AF160QG; SW_TL3305AF160QG; PARTREV C
U1: STM32L431CCUx; QFN-48-1EP_7x7mm_P0.5mm_EP5.6x5.6mm
Y1: ABM3B; XTAL_ABM3B-8.000MHZ-B2-T; PARTREV 08.25.15

Connections:
+3V3: C4.1, C5.1, C6.1, C7.1, C11.1, FB1.1, IC2.1 (V+), J4.2, R29.1, R30.1, U1.24 (VDD), U1.36 (VDD), U1.48 (VDD); also elsewhere on the board
/STM32L431_MCU/GPIO01: J4.3, U1.14 (PA4)
/STM32L431_MCU/GPIO02: J4.4, U1.15 (PA5)
/STM32L431_MCU/GPIO03: J4.5, U1.16 (PA6)
/STM32L431_MCU/GPIO05: J4.6, U1.18 (PB0)
/STM32L431_MCU/MCU_LED: R25.1, U1.17 (PA7)
/STM32L431_MCU/NRST: C1.1, S1.1, S1.2, U1.7 (NRST)
/STM32L431_MCU/SWCLK: J7.2, U1.37 (PA14)
/STM32L431_MCU/SWDIO: J7.1, U1.34 (PA13)
/STM32L431_MCU/SWO: J7.3, U1.39 (PB3)
/STM32L431_MCU/TMP451_SCL: IC2.8 (SCL), R29.2, U1.26 (PB13)
/STM32L431_MCU/TMP451_SDA: IC2.7 (SDA), R30.2, U1.27 (PB14)
/STM32L431_MCU/VDDA: C2.1, C3.1, FB1.2, U1.9 (VDDA)
GND: C1.2, C2.2, C3.2, C4.2, C5.2, C6.2, C7.2, C11.2, C49.1, C50.1, D5.1 (K), IC2.2 (D+), IC2.3 (D-), IC2.5 (GND), J4.1, R52.1, S1.3, S1.4, U1.8 (VSSA), U1.23 (VSS), U1.35 (VSS), U1.47 (VSS), U1.49 (VSS), Y1.2 (GND), Y1.4 (GND); also elsewhere on the board
unnamed: D5.2 (A), R25.2
unnamed: C49.2, U1.5 (PH0), Y1.1
unnamed: C50.2, U1.6 (PH1), Y1.3
unnamed: R52.2, U1.44 (PH3)
SIM68M_EXTINT: U1.20 (PB2); also elsewhere on the board
SIM68M_RXD/MCU_TX: U1.21 (PB10); also elsewhere on the board
SIM68M_TXD/MCU_RX: U1.22 (PB11); also elsewhere on the board
SIM7020E_GPIO1: U1.32 (PA11); also elsewhere on the board
SIM7020E_PWR: U1.33 (PA12); also elsewhere on the board
SIM7020E_RTC_EINT: U1.29 (PA8); also elsewhere on the board
SIM7020E_RXD/MCU_TX: U1.30 (PA9); also elsewhere on the board
SIM7020E_TXD/MCU_RX: U1.31 (PA10); also elsewhere on the board
SIM7020E_UART2_RXD/u_TX: U1.12 (PA2); also elsewhere on the board
SIM7020E_UART2_TXD/u_RX: U1.13 (PA3); also elsewhere on the board
Signal_VOUT: U1.45 (PB8); also elsewhere on the board

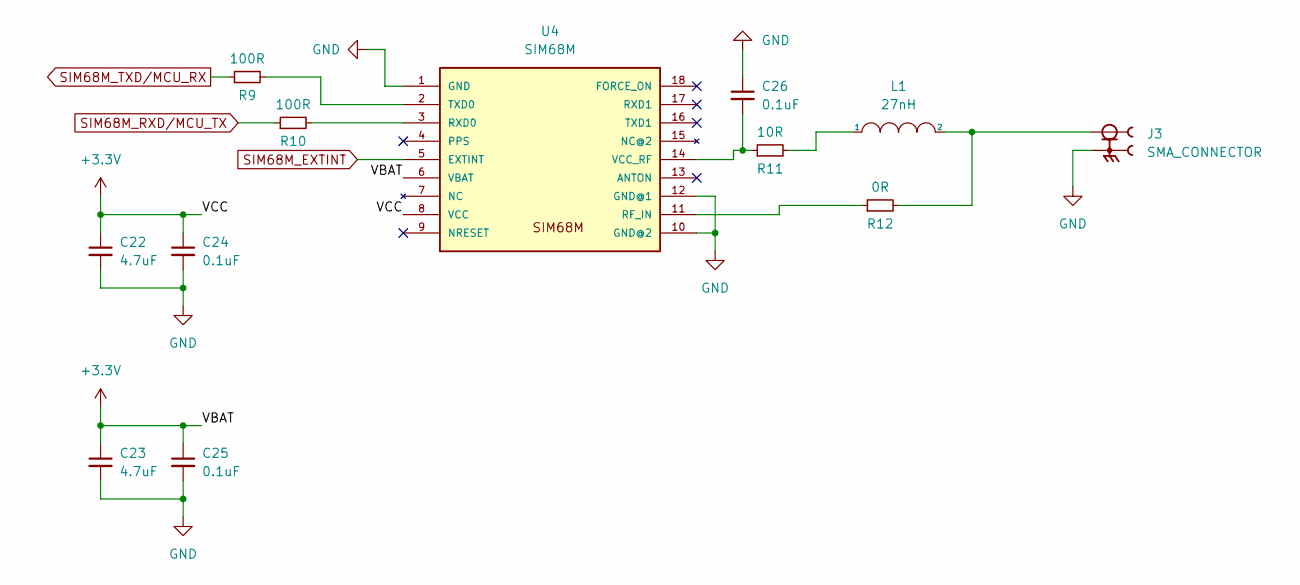
[picture p10: schematic SIM68M_GPS.kicad_sch]

Parts:
C22, C23: 4.7uF; C_0603_1608Metric
C24, C25, C26: 0.1uF; C_0603_1608Metric
J3: SMA_CONNECTOR; LPRS_SMA_CONNECTOR; PARTREV 1.3
L1: 27nH; L_0603_1608Metric
R9, R10: 100R; R_0603_1608Metric
R11: 10R; R_0603_1608Metric
R12: 0R; R_0603_1608Metric
U4: SIM68M

Connections:
+3V3: C22.1, C23.1, C24.1, C25.1, U4.6 (VBAT), U4.8 (VCC); also elsewhere on the board
GND: C22.2, C23.2, C24.2, C25.2, C26.1, J3.G1, J3.G2, J3.G3, J3.G4, U4.1 (GND), U4.10 (GND@2), U4.12 (GND@1); also elsewhere on the board
unnamed: C26.2, R11.1, U4.14 (VCC_RF)
unnamed: J3.1, L1.2, R12.2
unnamed: L1.1, R11.2
unnamed: R9.2, U4.2 (TXD0)
unnamed: R10.2, U4.3 (RXD0)
unnamed: R12.1, U4.11 (RF_IN)
SIM68M_EXTINT: U4.5 (EXTINT); also elsewhere on the board
SIM68M_RXD/MCU_TX: R10.1; also elsewhere on the board
SIM68M_TXD/MCU_RX: R9.1; also elsewhere on the board

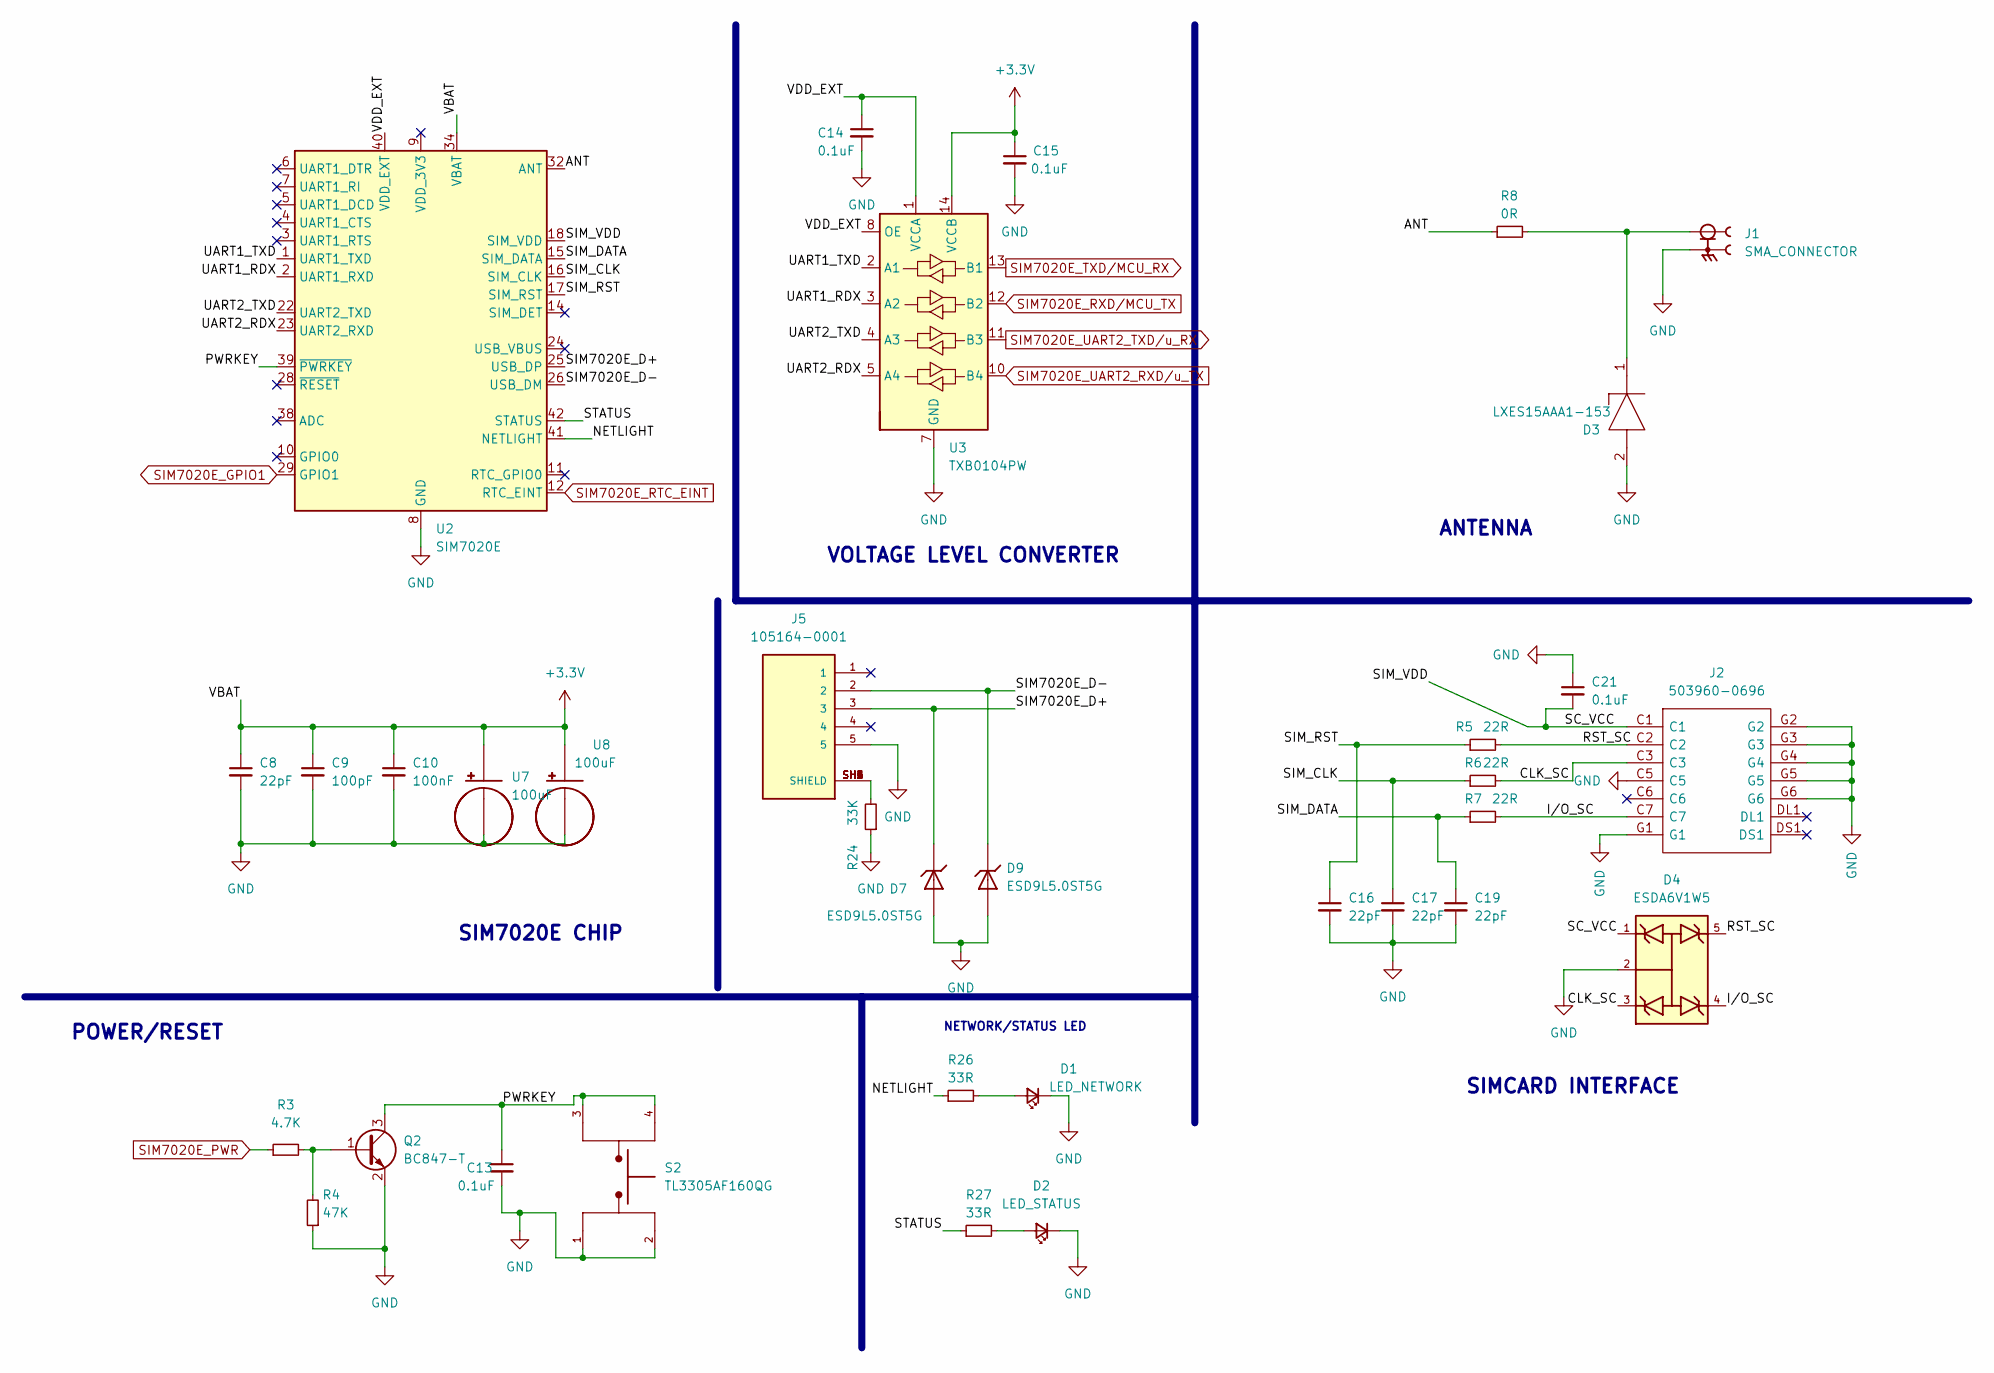
[picture p11: schematic SIM7020E.kicad_sch, SIM7020E_SHEET]

Parts:
C8: 22pF; C_0402_1005Metric
C9: 100pF; C_0402_1005Metric
C10: 100nF; C_0603_1608Metric
C13, C14, C15, C21: 0.1uF; C_0603_1608Metric
C16, C17, C19: 22pF; C_0603_1608Metric
D1: LED_NETWORK; LED_0805_2012Metric
D2: LED_STATUS; LED_0805_2012Metric
D3: LXES15AAA1-153; D_0402_1005Metric; Manufacturer_Part_Number ESD3V3D9-TP; Mouser Part Number 833-ESD3V3D9-TP
D4: ESDA6V1W5; SOT65P210X110-5N; PARTREV 2
D7, D9: ESD9L5.0ST5G; DIOM1006X40N; PARTREV 7
J1: SMA_CONNECTOR; LPRS_SMA_CONNECTOR; PARTREV 1.3
J2: 503960-0696; 5039600696; Manufacturer_Part_Number 503960-0696; Mouser Part Number 538-503960-0696
J5: 105164-0001; MOLEX_105164-0001; PARTREV B
Q2: BC847-T; SOT-23
R3: 4.7K; R_0603_1608Metric
R4: 47K; R_0603_1608Metric
R5, R6, R7: 22R; R_0603_1608Metric
R8: 0R; R_0603_1608Metric
R24: 33K; R_0603_1608Metric
R26, R27: 33R; R_0603_1608Metric
S2: TL3305AF160QG; SW_TL3305AF160QG; PARTREV C
U2: SIM7020E; SIMCom_SIM800C
U3: TXB0104PW; TSSOP-14_4.4x5mm_P0.65mm
U7, U8: 100uF; CAPMP7343X400N

Connections:
+3V3: C8.1, C9.1, C10.1, C15.1, U2.34 (VBAT), U2.35 (VBAT), U3.14 (VCCB), U7.+, U8.+; also elsewhere on the board
/SIM7020E/ANT: R8.1, U2.32 (ANT)
/SIM7020E/CLK_SC: D4.3, J2.C3, R6.2
/SIM7020E/I/O_SC: D4.4, J2.C7, R7.2
/SIM7020E/NETLIGHT: R26.1, U2.41 (NETLIGHT)
/SIM7020E/PWRKEY: C13.1, Q2.3 (C), S2.3, S2.4, U2.39 (~PWRKEY)
/SIM7020E/RST_SC: D4.5, J2.C2, R5.2
/SIM7020E/SC_VCC: C21.2, D4.1, J2.C1, U2.18 (SIM_VDD)
/SIM7020E/SIM7020E_D+: D7.C, J5.3, U2.25 (USB_DP)
/SIM7020E/SIM7020E_D-: D9.C, J5.2, U2.26 (USB_DM)
/SIM7020E/SIM_CLK: C17.1, R6.1, U2.16 (SIM_CLK)
/SIM7020E/SIM_DATA: C19.1, R7.1, U2.15 (SIM_DATA)
/SIM7020E/SIM_RST: C16.1, R5.1, U2.17 (SIM_RST)
/SIM7020E/STATUS: R27.1, U2.42 (STATUS)
/SIM7020E/UART1_RDX: U2.2 (UART1_RXD), U3.3 (A2)
/SIM7020E/UART1_TXD: U2.1 (UART1_TXD), U3.2 (A1)
/SIM7020E/UART2_RDX: U2.23 (UART2_RXD), U3.5 (A4)
/SIM7020E/UART2_TXD: U2.22 (UART2_TXD), U3.4 (A3)
/SIM7020E/VDD_EXT: C14.1, U2.40 (VDD_EXT), U3.1 (VCCA), U3.8 (OE)
GND: C8.2, C9.2, C10.2, C13.2, C14.2, C15.2, C16.2, C17.2, C19.2, C21.1, D1.1 (K), D2.1 (K), D3.2, D4.2, D7.A, D9.A, J1.G1, J1.G2, J1.G3, J1.G4, J2.C5, J2.G1, J2.G2, J2.G3, J2.G4, J2.G5, J2.G6, J5.5, Q2.2 (E), R4.1, R24.1, S2.1, S2.2, U2.8 (GND), U2.13 (GND), U2.19 (GND), U2.21 (GND), U2.27 (GND), U2.30 (GND), U2.31 (GND), U2.33 (GND), U2.36 (GND), U2.37 (GND), U3.7 (GND), U7.-, U8.-; also elsewhere on the board
unnamed: D1.2 (A), R26.2
unnamed: D2.2 (A), R27.2
unnamed: D3.1, J1.1, R8.2
unnamed: J5.SH1 (SHIELD), J5.SH2 (SHIELD), J5.SH3 (SHIELD), J5.SH4 (SHIELD), J5.SH5 (SHIELD), J5.SH6 (SHIELD), R24.2
unnamed: Q2.1 (B), R3.2, R4.2
SIM7020E_GPIO1: U2.29 (GPIO1); also elsewhere on the board
SIM7020E_PWR: R3.1; also elsewhere on the board
SIM7020E_RTC_EINT: U2.12 (RTC_EINT); also elsewhere on the board
SIM7020E_RXD/MCU_TX: U3.12 (B2); also elsewhere on the board
SIM7020E_TXD/MCU_RX: U3.13 (B1); also elsewhere on the board
SIM7020E_UART2_RXD/u_TX: U3.10 (B4); also elsewhere on the board
SIM7020E_UART2_TXD/u_RX: U3.11 (B3); also elsewhere on the board

Notes on the sheet:
SIMCARD INTERFACE
SIM7020E CHIP
VOLTAGE LEVEL CONVERTER
POWER/RESET
ANTENNA
NETWORK/STATUS LED

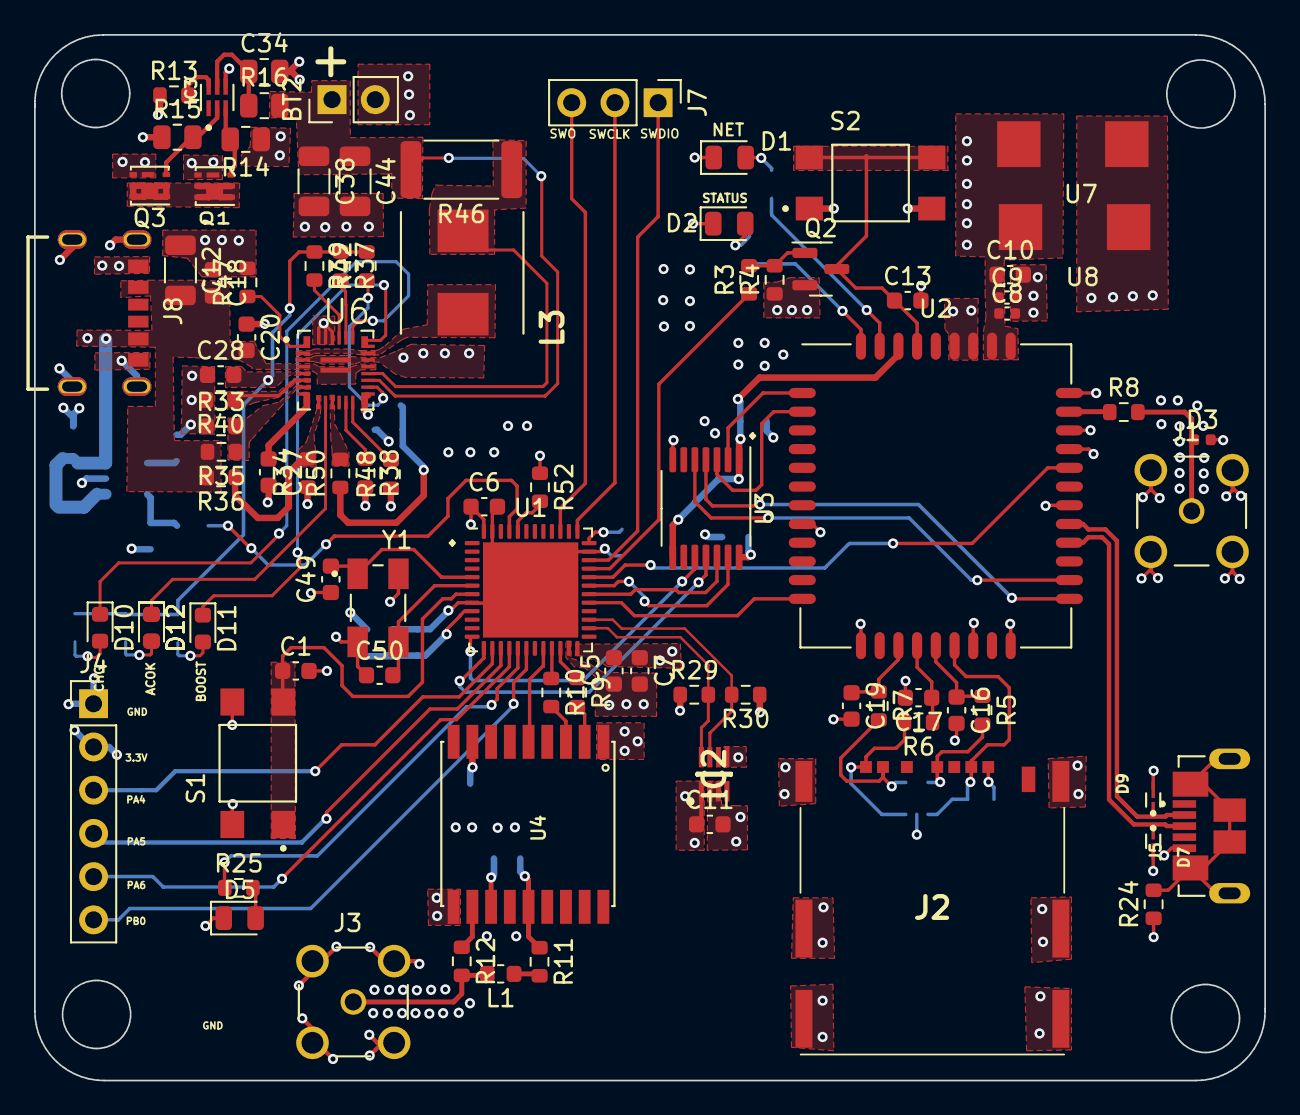
[picture p12: board HERTZ200.kicad_pcb from above]

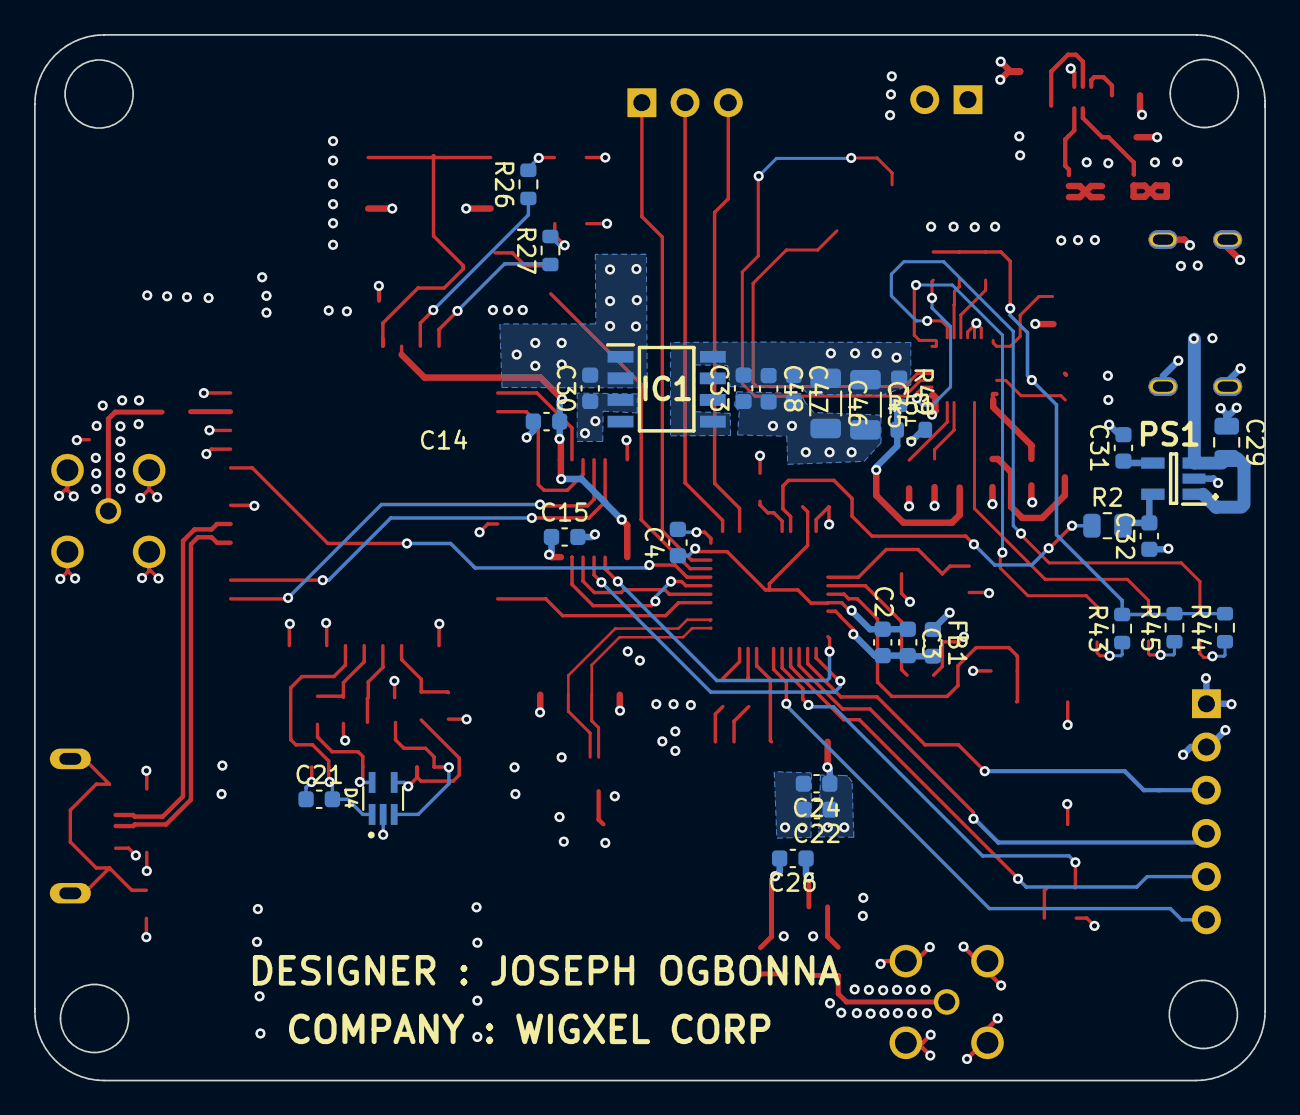
[picture p13: board HERTZ200.kicad_pcb from below]

Board: 4 copper layers, 72.3 x 61.5 mm, 119 parts (30 on the bottom side), 89 nets.

Other parts of the board:
D12#2: BLUE_LED; LED_0603_1608Metric

Their connections:
unnamed 53: D12#2.1 (K); also elsewhere on the board
unnamed 54: D12#2.2 (A); also elsewhere on the board
