Ogbonna-Joseph/HERTZ200/(commit log)

2022-08-29 TEMPERATURE SENSOR ROUTING
    [BOM.xlsx, BQ24195_SMPS.kicad_sch, HERTZ200.kicad_pcb, HERTZ200.kicad_sch, SIM68M_GPS.kicad_sch, SIM7020E.kicad_sch, STM32L432.kicad_sch]
2022-09-07 ROUTE DONE
    [BOM.xlsx, BQ24195_SMPS.kicad_sch, HERTZ200.kicad_pcb, HERTZ200.kicad_sch, MP2636.kicad_sch, SIM68M_GPS.kicad_sch, SIM7020E.kicad_sch, STM32L432.kicad_sch]
2022-09-10 Finished Schematics Review
    [BOM.xlsx, HERTZ200.kicad_pcb, HERTZ200.kicad_sch, STM32L432.kicad_sch]
